keshikan/CureSynth_Whip/hardware/schematic.pdf

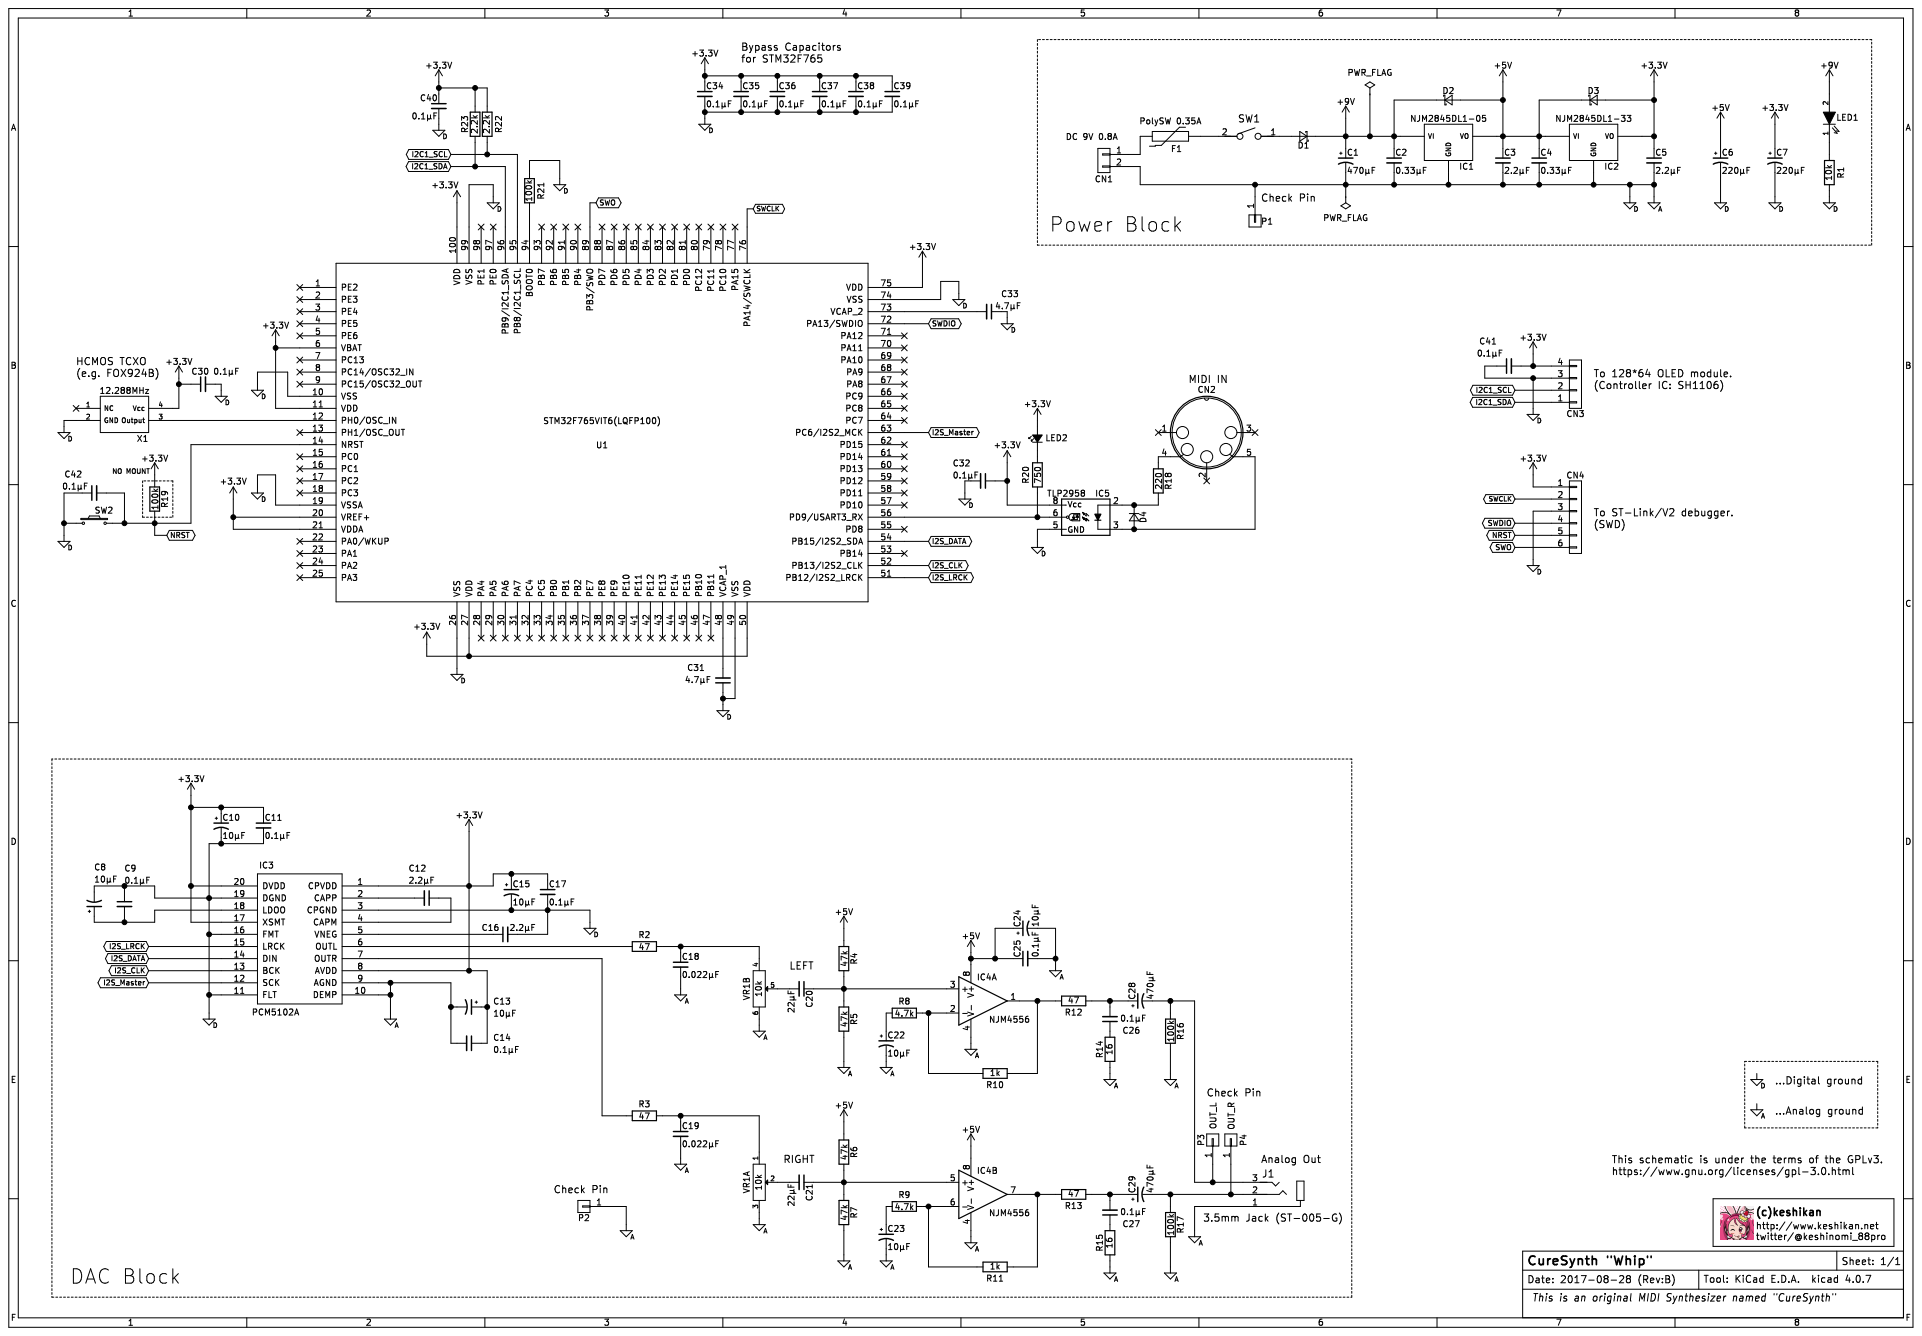
[picture p1: page 1]
