keshikan/CureSynth_Whip/software/SW4STM32_project/Src/main.c

/**
  ******************************************************************************
  * File Name          : main.c
  * Description        : Main program body
  ******************************************************************************
  ** This notice applies to any and all portions of this file
  * that are not between comment pairs USER CODE BEGIN and
  * USER CODE END. Other portions of this file, whether 
  * inserted by the user or by software development tools
  * are owned by their respective copyright owners.
  *
  * COPYRIGHT(c) 2017 STMicroelectronics
  *
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
  ******************************************************************************
  */
/* Includes ------------------------------------------------------------------*/
#include "main.h"
#include "stm32f7xx_hal.h"

/* USER CODE BEGIN Includes */

#include<stdio.h>

#include "curelib_inc/curemidi.h"
#include "curelib_inc/curemisc.h"
#include "curelib_inc/curedisplay.h"
#include "curelib_inc/curedbg.h"


/* USER CODE END Includes */


I2C_HandleTypeDef hi2c1;
DMA_HandleTypeDef hdma_i2c1_tx;

I2S_HandleTypeDef hi2s2;
DMA_HandleTypeDef hdma_spi2_tx;

TIM_HandleTypeDef htim7;

UART_HandleTypeDef huart1;
UART_HandleTypeDef huart3;

/* USER CODE BEGIN PV */

//for MIDI rx
uint8_t midi_recieved_buf;

//for audio output
int16_t audio_output[2];
uint16_t audio_output_i2s[2];
uint8_t i2s_transmitted=true;

//for output buffer
#define OUTPUT_BUFFERSIZE (1024) //need 2^n

typedef struct{

	uint16_t buffer[OUTPUT_BUFFERSIZE * 2];
	volatile uint16_t idx;
	uint8_t started_flag;
	int16_t err_distance;

}OutputBuffer;

OutputBuffer outbuf;

//for display
uint8_t display_update_flag = false;

/* USER CODE END PV */

void SystemClock_Config(void);
static void MX_GPIO_Init(void);
static void MX_DMA_Init(void);
static void MX_USART3_UART_Init(void);
static void MX_TIM7_Init(void);
static void MX_I2S2_Init(void);
static void MX_USART1_UART_Init(void);
static void MX_I2C1_Init(void);
static void MX_NVIC_Init(void);

/* USER CODE BEGIN PFP */

/* USER CODE END PFP */

/* USER CODE BEGIN 0 */

void cureInit(){

	outbuf.idx = 0;
	outbuf.started_flag = false;
	outbuf.err_distance = 0;

	HAL_I2C_Master_Transmit(&hi2c1, 0x78, disp_settings, DISP_INITSIZE, 1000);
	HAL_I2C_Master_Transmit(&hi2c1, 0x78, (uint8_t *)disp_memory, 2096, 1000);

}

void cureErr()
{
	while(1);
}

void cureMonitoringBuffer()
{
	//monitoring output buffer.
	if(outbuf.err_distance < -1 * OUTPUT_BUFFERSIZE){ //if buffer under-run error occurs.
		outbuf.idx += OUTPUT_BUFFERSIZE;
		outbuf.err_distance += OUTPUT_BUFFERSIZE;
	}else if (OUTPUT_BUFFERSIZE < outbuf.err_distance){ //if buffer over-run error occurs.
		outbuf.idx -= OUTPUT_BUFFERSIZE;
		outbuf.err_distance -= OUTPUT_BUFFERSIZE;
	}
}

void cureUpdateDisplay()
{
	if(disp_transmitted == true){
		cureSynthUpdateDisplayData();
		displaySetData(display_data);
		HAL_I2C_Master_Transmit_DMA(&hi2c1, 0x78, (uint8_t *)disp_memory, 2096);
		disp_transmitted = false;
	}
}


void HAL_I2C_MasterTxCpltCallback(I2C_HandleTypeDef *hi2c){

	if(hi2c->Instance == I2C1)
	{
		disp_transmitted = true;
	}
}

void HAL_UART_RxCpltCallback(UART_HandleTypeDef *huart)
{
	if(huart->Instance == USART3)
	{

		GPIOC->ODR |= GPIO_PIN_9;
		cureMidiBufferEnqueue(&midi_recieved_buf);
		HAL_UART_Receive_IT(&huart3, &midi_recieved_buf,1);
	}
}

void HAL_UART_TxCpltCallback(UART_HandleTypeDef *huart){
	if(huart->Instance == USART1)
	{
	}
}

void HAL_UART_ErrorCallback(UART_HandleTypeDef *huart){


}

void HAL_TIM_PeriodElapsedCallback(TIM_HandleTypeDef *htim)
{

	if(htim->Instance == TIM7)
	{
#if CUREDBG_CPU_USAGE
		GPIOA->ODR |= GPIO_PIN_0;
#endif

		cureSynthGetOutput(audio_output);

		audio_output_i2s[0] = (uint16_t)(audio_output[0] + 32768);
		audio_output_i2s[1] = (uint16_t)(audio_output[1] + 32768);

		//store output buffer
		outbuf.buffer[outbuf.idx] = audio_output_i2s[0];
		outbuf.buffer[outbuf.idx+1] = audio_output_i2s[1];
		outbuf.idx+=2;
		outbuf.idx &= (OUTPUT_BUFFERSIZE*2 -1);
		outbuf.err_distance+=2;

		//set internal DAC.
//		HAL_DAC_SetValue(&hdac, DAC_CHANNEL_1, DAC_ALIGN_12B_R, (uint32_t)(audio_output_i2s[0] >> 4) );
//		HAL_DAC_SetValue(&hdac, DAC_CHANNEL_2, DAC_ALIGN_12B_R, (uint32_t)(audio_output_i2s[1] >> 4) );


#if CUREDBG_CPU_USAGE
		GPIOA->ODR &= ~GPIO_PIN_0;
#endif

	}


}

void HAL_I2S_TxHalfCpltCallback(I2S_HandleTypeDef *hi2s){

	if(hi2s->Instance == SPI2)
	{
		outbuf.err_distance -= OUTPUT_BUFFERSIZE;
	}
}

void HAL_I2S_TxCpltCallback(I2S_HandleTypeDef *hi2s){

	if(hi2s->Instance == SPI2)
	{
		outbuf.err_distance -= OUTPUT_BUFFERSIZE;
	}
}

/* USER CODE END 0 */

int main(void)
{

  /* Enable I-Cache-------------------------------------------------------------*/
  SCB_EnableICache();

  /* Enable D-Cache-------------------------------------------------------------*/
  SCB_EnableDCache();

  /* MCU Configuration----------------------------------------------------------*/

  /* Reset of all peripherals, Initializes the Flash interface and the Systick. */
  HAL_Init();

  /* USER CODE BEGIN Init */

	setbuf(stdout, NULL);

  /* USER CODE END Init */

  /* Configure the system clock */
  SystemClock_Config();

  /* Initialize all configured peripherals */
  MX_GPIO_Init();
  MX_DMA_Init();
  MX_USART3_UART_Init();
  MX_TIM7_Init();
  MX_I2S2_Init();
  MX_USART1_UART_Init();
  MX_I2C1_Init();

  /* Initialize interrupts */
  MX_NVIC_Init();

  /* USER CODE BEGIN 2 */

	//MIDI Initializations.
	if( FUNC_ERROR == cureMidiInit() ){
#if CUREDBG_UART
		printf("Initialization failed.");
#endif
		while(1);
	}

	//start internal DAC
//	HAL_DAC_Start(&hdac, DAC_CHANNEL_1);
//	HAL_DAC_Start(&hdac, DAC_CHANNEL_2);

	//start MIDI message reception with interrupt.
	HAL_UART_Receive_IT(&huart3, &midi_recieved_buf, 1);

	//start sound generate timer.
	HAL_TIM_Base_Start_IT(&htim7);


#if CUREDBG_UART
	printf("\r\n-----------------------------------------\r\n");
	printf("CureSynth System (F7 Edition) is running.\r\n");
	printf("-----------------------------------------\r\n");

	printf("char_size=%d\r\n",sizeof(char));
	printf("short_size=%d\r\n",sizeof(short));
	printf("int_size=%d\r\n",sizeof(int));
	printf("long_size=%d\r\n",sizeof(long));
	printf("longlong_size=%d\r\n",sizeof(long long));
	printf("-----------------------------------------\r\n\r\n");

#endif


	//start display data sending.

	displayInit();
	cureInit();

	while(1)
	{
		if((outbuf.idx) > ( OUTPUT_BUFFERSIZE ) ){
			HAL_I2S_Transmit_DMA(&hi2s2, outbuf.buffer, OUTPUT_BUFFERSIZE * 2);
			outbuf.err_distance = 0;
			break;
		}
	}


  /* USER CODE END 2 */

  /* Infinite loop */
  /* USER CODE BEGIN WHILE */
	while (1)
	{
  /* USER CODE END WHILE */

  /* USER CODE BEGIN 3 */

		cureMidiMain();

		//MIDI LED OFF
		GPIOC->ODR &= ~GPIO_PIN_9;

		cureMonitoringBuffer();

		if( cureMidiBufferIsEmpty() ){
			cureUpdateDisplay();
		}

	}
  /* USER CODE END 3 */

}

/** System Clock Configuration
*/
void SystemClock_Config(void)
{

  RCC_OscInitTypeDef RCC_OscInitStruct;
  RCC_ClkInitTypeDef RCC_ClkInitStruct;
  RCC_PeriphCLKInitTypeDef PeriphClkInitStruct;

    /**Configure the main internal regulator output voltage 
    */
  __HAL_RCC_PWR_CLK_ENABLE();

  __HAL_PWR_VOLTAGESCALING_CONFIG(PWR_REGULATOR_VOLTAGE_SCALE1);

    /**Initializes the CPU, AHB and APB busses clocks 
    */
  RCC_OscInitStruct.OscillatorType = RCC_OSCILLATORTYPE_HSI|RCC_OSCILLATORTYPE_HSE;
  RCC_OscInitStruct.HSEState = RCC_HSE_ON;
  RCC_OscInitStruct.HSIState = RCC_HSI_ON;
  RCC_OscInitStruct.HSICalibrationValue = 11;
  RCC_OscInitStruct.PLL.PLLState = RCC_PLL_ON;
  RCC_OscInitStruct.PLL.PLLSource = RCC_PLLSOURCE_HSE;
  RCC_OscInitStruct.PLL.PLLM = 6;
  RCC_OscInitStruct.PLL.PLLN = 210;
  RCC_OscInitStruct.PLL.PLLP = RCC_PLLP_DIV2;
  RCC_OscInitStruct.PLL.PLLQ = 2;
  if (HAL_RCC_OscConfig(&RCC_OscInitStruct) != HAL_OK)
  {
    _Error_Handler(__FILE__, __LINE__);
  }

    /**Activate the Over-Drive mode 
    */
  if (HAL_PWREx_EnableOverDrive() != HAL_OK)
  {
    _Error_Handler(__FILE__, __LINE__);
  }

    /**Initializes the CPU, AHB and APB busses clocks 
    */
  RCC_ClkInitStruct.ClockType = RCC_CLOCKTYPE_HCLK|RCC_CLOCKTYPE_SYSCLK
                              |RCC_CLOCKTYPE_PCLK1|RCC_CLOCKTYPE_PCLK2;
  RCC_ClkInitStruct.SYSCLKSource = RCC_SYSCLKSOURCE_PLLCLK;
  RCC_ClkInitStruct.AHBCLKDivider = RCC_SYSCLK_DIV1;
  RCC_ClkInitStruct.APB1CLKDivider = RCC_HCLK_DIV4;
  RCC_ClkInitStruct.APB2CLKDivider = RCC_HCLK_DIV2;

  if (HAL_RCC_ClockConfig(&RCC_ClkInitStruct, FLASH_LATENCY_7) != HAL_OK)
  {
    _Error_Handler(__FILE__, __LINE__);
  }

  PeriphClkInitStruct.PeriphClockSelection = RCC_PERIPHCLK_USART1|RCC_PERIPHCLK_USART3
                              |RCC_PERIPHCLK_I2C1|RCC_PERIPHCLK_I2S;
  PeriphClkInitStruct.PLLI2S.PLLI2SN = 144;
  PeriphClkInitStruct.PLLI2S.PLLI2SP = RCC_PLLP_DIV2;
  PeriphClkInitStruct.PLLI2S.PLLI2SR = 3;
  PeriphClkInitStruct.PLLI2S.PLLI2SQ = 2;
  PeriphClkInitStruct.PLLI2SDivQ = 1;
  PeriphClkInitStruct.I2sClockSelection = RCC_I2SCLKSOURCE_PLLI2S;
  PeriphClkInitStruct.Usart1ClockSelection = RCC_USART1CLKSOURCE_PCLK2;
  PeriphClkInitStruct.Usart3ClockSelection = RCC_USART3CLKSOURCE_HSI;
  PeriphClkInitStruct.I2c1ClockSelection = RCC_I2C1CLKSOURCE_PCLK1;
  if (HAL_RCCEx_PeriphCLKConfig(&PeriphClkInitStruct) != HAL_OK)
  {
    _Error_Handler(__FILE__, __LINE__);
  }

    /**Configure the Systick interrupt time 
    */
  HAL_SYSTICK_Config(HAL_RCC_GetHCLKFreq()/1000);

    /**Configure the Systick 
    */
  HAL_SYSTICK_CLKSourceConfig(SYSTICK_CLKSOURCE_HCLK);

  /* SysTick_IRQn interrupt configuration */
  HAL_NVIC_SetPriority(SysTick_IRQn, 0, 0);
}

/** NVIC Configuration
*/
static void MX_NVIC_Init(void)
{
  /* DMA1_Stream4_IRQn interrupt configuration */
  HAL_NVIC_SetPriority(DMA1_Stream4_IRQn, 0, 1);
  HAL_NVIC_EnableIRQ(DMA1_Stream4_IRQn);
  /* DMA1_Stream6_IRQn interrupt configuration */
  HAL_NVIC_SetPriority(DMA1_Stream6_IRQn, 2, 0);
  HAL_NVIC_EnableIRQ(DMA1_Stream6_IRQn);
  /* I2C1_EV_IRQn interrupt configuration */
  HAL_NVIC_SetPriority(I2C1_EV_IRQn, 2, 0);
  HAL_NVIC_EnableIRQ(I2C1_EV_IRQn);
}

/* I2C1 init function */
static void MX_I2C1_Init(void)
{

  hi2c1.Instance = I2C1;
  hi2c1.Init.Timing = 0x00201269;
  hi2c1.Init.OwnAddress1 = 0;
  hi2c1.Init.AddressingMode = I2C_ADDRESSINGMODE_7BIT;
  hi2c1.Init.DualAddressMode = I2C_DUALADDRESS_DISABLE;
  hi2c1.Init.OwnAddress2 = 0;
  hi2c1.Init.OwnAddress2Masks = I2C_OA2_NOMASK;
  hi2c1.Init.GeneralCallMode = I2C_GENERALCALL_DISABLE;
  hi2c1.Init.NoStretchMode = I2C_NOSTRETCH_DISABLE;
  if (HAL_I2C_Init(&hi2c1) != HAL_OK)
  {
    _Error_Handler(__FILE__, __LINE__);
  }

    /**Configure Analogue filter 
    */
  if (HAL_I2CEx_ConfigAnalogFilter(&hi2c1, I2C_ANALOGFILTER_ENABLE) != HAL_OK)
  {
    _Error_Handler(__FILE__, __LINE__);
  }

    /**Configure Digital filter 
    */
  if (HAL_I2CEx_ConfigDigitalFilter(&hi2c1, 0) != HAL_OK)
  {
    _Error_Handler(__FILE__, __LINE__);
  }

    /**I2C Enable Fast Mode Plus 
    */
  HAL_I2CEx_EnableFastModePlus(I2C_FASTMODEPLUS_I2C1);

}

/* I2S2 init function */
static void MX_I2S2_Init(void)
{

  hi2s2.Instance = SPI2;
  hi2s2.Init.Mode = I2S_MODE_MASTER_TX;
  hi2s2.Init.Standard = I2S_STANDARD_MSB;
  hi2s2.Init.DataFormat = I2S_DATAFORMAT_16B_EXTENDED;
  hi2s2.Init.MCLKOutput = I2S_MCLKOUTPUT_ENABLE;
  hi2s2.Init.AudioFreq = 32000;
  hi2s2.Init.CPOL = I2S_CPOL_HIGH;
  hi2s2.Init.ClockSource = I2S_CLOCK_PLL;
  if (HAL_I2S_Init(&hi2s2) != HAL_OK)
  {
    _Error_Handler(__FILE__, __LINE__);
  }

}

/* TIM7 init function */
static void MX_TIM7_Init(void)
{

  TIM_MasterConfigTypeDef sMasterConfig;

  htim7.Instance = TIM7;
  htim7.Init.Prescaler = 59;
  htim7.Init.CounterMode = TIM_COUNTERMODE_UP;
  htim7.Init.Period = 55;
  htim7.Init.AutoReloadPreload = TIM_AUTORELOAD_PRELOAD_DISABLE;
  if (HAL_TIM_Base_Init(&htim7) != HAL_OK)
  {
    _Error_Handler(__FILE__, __LINE__);
  }

  sMasterConfig.MasterOutputTrigger = TIM_TRGO_RESET;
  sMasterConfig.MasterSlaveMode = TIM_MASTERSLAVEMODE_DISABLE;
  if (HAL_TIMEx_MasterConfigSynchronization(&htim7, &sMasterConfig) != HAL_OK)
  {
    _Error_Handler(__FILE__, __LINE__);
  }

}

/* USART1 init function */
static void MX_USART1_UART_Init(void)
{

  huart1.Instance = USART1;
  huart1.Init.BaudRate = 1843200;
  huart1.Init.WordLength = UART_WORDLENGTH_8B;
  huart1.Init.StopBits = UART_STOPBITS_1;
  huart1.Init.Parity = UART_PARITY_NONE;
  huart1.Init.Mode = UART_MODE_TX;
  huart1.Init.HwFlowCtl = UART_HWCONTROL_NONE;
  huart1.Init.OverSampling = UART_OVERSAMPLING_16;
  huart1.Init.OneBitSampling = UART_ONE_BIT_SAMPLE_DISABLE;
  huart1.AdvancedInit.AdvFeatureInit = UART_ADVFEATURE_NO_INIT;
  if (HAL_UART_Init(&huart1) != HAL_OK)
  {
    _Error_Handler(__FILE__, __LINE__);
  }

}

/* USART3 init function */
static void MX_USART3_UART_Init(void)
{

  huart3.Instance = USART3;
  huart3.Init.BaudRate = 31250;
  huart3.Init.WordLength = UART_WORDLENGTH_8B;
  huart3.Init.StopBits = UART_STOPBITS_1;
  huart3.Init.Parity = UART_PARITY_NONE;
  huart3.Init.Mode = UART_MODE_RX;
  huart3.Init.HwFlowCtl = UART_HWCONTROL_NONE;
  huart3.Init.OverSampling = UART_OVERSAMPLING_16;
  huart3.Init.OneBitSampling = UART_ONE_BIT_SAMPLE_DISABLE;
  huart3.AdvancedInit.AdvFeatureInit = UART_ADVFEATURE_NO_INIT;
  if (HAL_UART_Init(&huart3) != HAL_OK)
  {
    _Error_Handler(__FILE__, __LINE__);
  }

}

/** 
  * Enable DMA controller clock
  */
static void MX_DMA_Init(void) 
{
  /* DMA controller clock enable */
  __HAL_RCC_DMA1_CLK_ENABLE();

}

/** Configure pins as 
        * Analog 
        * Input 
        * Output
        * EVENT_OUT
        * EXTI
*/
static void MX_GPIO_Init(void)
{

  GPIO_InitTypeDef GPIO_InitStruct;

  /* GPIO Ports Clock Enable */
  __HAL_RCC_GPIOC_CLK_ENABLE();
  __HAL_RCC_GPIOH_CLK_ENABLE();
  __HAL_RCC_GPIOB_CLK_ENABLE();
  __HAL_RCC_GPIOD_CLK_ENABLE();
  __HAL_RCC_GPIOA_CLK_ENABLE();

  /*Configure GPIO pins : PC13 PC14 PC15 */
  GPIO_InitStruct.Pin = GPIO_PIN_13|GPIO_PIN_14|GPIO_PIN_15;
  GPIO_InitStruct.Mode = GPIO_MODE_INPUT;
  GPIO_InitStruct.Pull = GPIO_NOPULL;
  HAL_GPIO_Init(GPIOC, &GPIO_InitStruct);

}

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
