keshikan/CureSynth_Whip/software/SW4STM32_project/CureSynth_Whip.ioc

Mcu.UserName=STM32F765VITx
PA13.Signal=SYS_JTMS-SWDIO
PA14.Signal=SYS_JTCK-SWCLK
PA15.Signal=SYS_JTDI
PB12.Signal=I2S2_WS
PB13.Signal=I2S2_CK
PB15.Signal=I2S2_SD
PB3.Signal=SYS_JTDO-SWO
PB4.Signal=SYS_JTRST
PB6.Signal=USART1_TX
PB7.Signal=USART1_RX
PB8.Signal=I2C1_SCL
PB9.Signal=I2C1_SDA
PC13.Signal=GPIO_Input
PC14/OSC32_IN.Signal=GPIO_Input
PC15/OSC32_OUT.Signal=GPIO_Input
PC6.Signal=I2S2_MCK
PD8.Signal=USART3_TX
PD9.GPIO_Label=MIDI_IN_RX
PD9.Signal=USART3_RX
PH0/OSC_IN.Signal=RCC_OSC_IN
PH1/OSC_OUT.Signal=RCC_OSC_OUT
