keshikan/CureSynth_Whip/software/SW4STM32_project/Inc/curelib_inc/patchlist.h

/*
 *******************************************************************************
 *  [patchlist.h]
 *  This header file contains patch-lists for GM1 mode.
 *
 *  This program is under the terms of the GPLv3.
 *  https://www.gnu.org/licenses/gpl-3.0.html
 *
 *  Copyright(c) 2017 Keshikan (www.keshikan.net)
 *******************************************************************************
 */

#ifndef CURELIB_INC_PATCHLIST_H_
#define CURELIB_INC_PATCHLIST_H_

#include "curelib_inc/curemidi.h"

//GM1 Patch for melody instruments.
const MidiPatch patch_melody[128] = {
		// note type  wave  rm  rg  Sweeptyp  spd A  D   SL  SR  R  Nt  Gain
		{NOTE_MELODY, SINE, 31, 70, SWEEP_NONE, 0, 0, 5, 90, 12, 0, 0, 48},
		{NOTE_MELODY, TRIANGLE, 31, 100, SWEEP_NONE, 0, 0, 5, 90, 12, 0, 0, 64},
		{NOTE_MELODY, TRIANGLE, 31, 110, SWEEP_NONE, 0, 0, 5, 90, 12, 0, 0, 64},
		{NOTE_MELODY, SINE, 31, 100, SWEEP_NONE, 0, 0, 15, 90, 12, 0, 0, 50},
		{NOTE_MELODY, SINE, 95, 80, SWEEP_NONE, 0, 0, 5, 90, 12, 0, 0, 34},
		{NOTE_MELODY, SINE, 127, 100, SWEEP_NONE, 0, 0, 5, 90, 12, 0, 0, 34},
		{NOTE_MELODY, SAW, 63, 35, SWEEP_NONE, 0, 0, 10, 50, 9, 0, 0, 30},
		{NOTE_MELODY, SAW, 63, 127, SWEEP_NONE, 0, 0, 10, 50, 23, 0, 0, 50},
		{NOTE_MELODY, TRIANGLE, 127, 90, SWEEP_NONE, 0, 0, 10, 50, 23, 0, 0, 50},
		{NOTE_MELODY, SINE, 115, 80, SWEEP_NONE, 0, 0, 10, 50, 15, 0, 0, 50},
		{NOTE_DRUM, SINE, 95, 40, SWEEP_NONE, 0, 0, 15, 40, 15, 0, 0, 45},
		{NOTE_MELODY, SINE, 95, 80, SWEEP_NONE, 0, 0, 10, 80, 12, 50, 0, 38},
		{NOTE_MELODY, TRIANGLE, 127, 80, SWEEP_NONE, 0, 0, 10, 50, 45, 15, 0, 64},
		{NOTE_DRUM, TRIANGLE, 63, 80, SWEEP_NONE, 0, 0, 5, 50, 80, 0, 0, 66},
		{NOTE_DRUM, TRIANGLE, 79, 45, SWEEP_NONE, 0, 0, 5, 50, 10, 0, 0, 64},
		{NOTE_MELODY, TRIANGLE, 79, 70, SWEEP_NONE, 0, 0, 5, 50, 30, 10, 0, 60},
		{NOTE_MELODY, SINE, 95, 64, SWEEP_NONE, 0, 1, 2, 100, 0, 0, 0, 38},
		{NOTE_MELODY, SINE, 95, 40, SWEEP_NONE, 0, 1, 20, 40, 0, 0, 0, 64},
		{NOTE_MELODY, SINE, 47, 80, SWEEP_NONE, 0, 1, 20, 40, 0, 0, 0, 64},
		{NOTE_MELODY, SQUARE, 95, 127, SWEEP_NONE, 0, 3, 20, 80, 0, 6, 0, 28},
		{NOTE_MELODY, SAW, 95, 127, SWEEP_NONE, 0, 5, 20, 80, 0, 6, 0, 40},
		{NOTE_MELODY, SAW, 63, 127, SWEEP_NONE, 0, 5, 20, 80, 0, 6, 0, 50},
		{NOTE_MELODY, SAW, 63, 40, SWEEP_NONE, 0, 8, 20, 80, 0, 3, 0, 37},
		{NOTE_MELODY, SAW, 63, 40, SWEEP_NONE, 0, 8, 20, 80, 0, 3, 0, 37},
		{NOTE_MELODY, TRIANGLE, 63, 100, SWEEP_NONE, 0, 0, 3, 80, 10, 3, 0, 53},
		{NOTE_MELODY, TRIANGLE, 63, 65, SWEEP_NONE, 0, 0, 3, 80, 10, 3, 0, 50},
		{NOTE_MELODY, TRIANGLE, 95, 100, SWEEP_NONE, 0, 0, 3, 80, 10, 3, 0, 48},
		{NOTE_MELODY, TRIANGLE, 95, 65, SWEEP_NONE, 0, 0, 3, 80, 10, 3, 0, 46},
		{NOTE_MELODY, TRIANGLE, 95, 65, SWEEP_NONE, 0, 0, 3, 80, 52, 3, 0, 64},
		{NOTE_MELODY, SQUARE, 95, 100, SWEEP_NONE, 0, 0, 3, 80, 0, 3, 0, 30},
		{NOTE_MELODY, SQUARE, 79, 80, SWEEP_NONE, 0, 0, 3, 80, 0, 3, 0, 31},
		{NOTE_MELODY, SQUARE, 31, 120, SWEEP_NONE, 0, 0, 3, 80, 5, 3, 0, 50},
		{NOTE_MELODY, TRIANGLE, 63, 120, SWEEP_NONE, 0, 0, 2, 80, 4, 3, 0, 57},
		{NOTE_MELODY, TRIANGLE, 63, 40, SWEEP_NONE, 0, 0, 2, 80, 4, 3, 0, 47},
		{NOTE_MELODY, SINE, 63, 40, SWEEP_NONE, 0, 0, 2, 80, 4, 3, 0, 45},
		{NOTE_MELODY, SAW, 31, 120, SWEEP_NONE, 0, 0, 2, 80, 4, 3, 0, 70},
		{NOTE_MELODY, SAW, 63, 90, SWEEP_NONE, 0, 0, 5, 60, 4, 3, 0, 55},
		{NOTE_MELODY, SAW, 63, 110, SWEEP_NONE, 0, 0, 5, 60, 4, 3, 0, 55},
		{NOTE_MELODY, SQUARE, 63, 20, SWEEP_NONE, 0, 0, 5, 60, 4, 3, 0, 40},
		{NOTE_MELODY, SQUARE, 63, 70, SWEEP_NONE, 0, 0, 5, 60, 4, 3, 0, 40},
		{NOTE_MELODY, SAW, 63, 70, SWEEP_NONE, 0, 8, 5, 60, 0, 6, 0, 62},
		{NOTE_MELODY, SAW, 63, 110, SWEEP_NONE, 0, 8, 5, 60, 0, 6, 0, 65},
		{NOTE_MELODY, SAW, 63, 120, SWEEP_NONE, 0, 8, 5, 60, 0, 6, 0, 64},
		{NOTE_MELODY, SAW, 95, 127, SWEEP_NONE, 0, 8, 5, 60, 0, 6, 0, 58},
		{NOTE_MELODY, SQUARE, 31, 127, SWEEP_NONE, 0, 8, 5, 60, 0, 6, 0, 64},
		{NOTE_DRUM, SQUARE, 31, 127, SWEEP_NONE, 0, 0, 5, 60, 75, 0, 0, 64},
		{NOTE_MELODY, TRIANGLE, 31, 80, SWEEP_NONE, 0, 0, 4, 60, 30, 15, 0, 73},
		{NOTE_MELODY, TRIANGLE, 31, 40, SWEEP_NONE, 0, 0, 4, 30, 10, 30, 0, 120},
		{NOTE_MELODY, SQUARE, 31, 105, SWEEP_NONE, 0, 8, 5, 60, 0, 6, 0, 60},
		{NOTE_MELODY, SQUARE, 31, 105, SWEEP_NONE, 0, 25, 20, 80, 0, 6, 0, 52},
		{NOTE_MELODY, SAW, 31, 110, SWEEP_NONE, 0, 15, 20, 80, 0, 6, 0, 64},
		{NOTE_MELODY, SAW, 31, 127, SWEEP_NONE, 0, 15, 20, 80, 0, 6, 0, 64},
		{NOTE_MELODY, SAW, 47, 127, SWEEP_NONE, 0, 15, 20, 80, 0, 6, 0, 46},
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
		{NOTE_MELODY, SAW, 95, 100, SWEEP_NONE, 0, 8, 3, 45, 0, 3, 0, 55},
		{NOTE_MELODY, SINE, 79, 100, SWEEP_NONE, 0, 0, 8, 45, 25, 35, 0, 55},
		{NOTE_DRUM, SINE, 127, 100, SWEEP_NONE, 40, 0, 8, 45, 110, 6, 0, 48},
		{NOTE_DRUM, SINE, 127, 110, SWEEP_NONE, 0, 0, 8, 45, 52, 5, 0, 48},
		{NOTE_DRUM, SINE, 100, 50, SWEEP_NONE, 50, 0, 8, 45, 120, 5, 0, 48},
		{NOTE_DRUM, TRIANGLE, 20, 127, SWEEP_DOWN, 35, 0, 8, 80, 127, 5, 0, 48},
		{NOTE_DRUM, SINE, 31, 127, SWEEP_DOWN, 35, 0, 8, 80, 127, 5, 0, 48},
		{NOTE_DRUM, SQUARE, 31, 127, SWEEP_DOWN, 35, 0, 8, 80, 127, 5, 0, 48},
		{NOTE_DRUM, NOISE, 31, 0, SWEEP_NONE, 5, 127, 8, 127, 0, 5, 0, 23},
		{NOTE_DRUM, SQUARE, 31, 127, SWEEP_UP, 30, 3, 8, 50, 0, 5, 0, 40},
		{NOTE_DRUM, NOISE, 31, 0, SWEEP_NONE, 10, 8, 8, 50, 127, 5, 0, 20},
		{NOTE_MELODY, NOISE, 0, 127, SWEEP_NONE, 0, 8, 8, 50, 0, 5, 0, 35},
		{NOTE_MELODY, SINE, 0, 0, SWEEP_UP, 100, 8, 8, 50, 0, 5, 0, 25},
		{NOTE_MELODY, SINE, 0, 127, SWEEP_NONE, 0, 0, 0, 127, 0, 0, 0, 25},
		{NOTE_MELODY, NOISE, 1, 127, SWEEP_NONE, 0, 127, 0, 127, 0, 50, 0, 17},
		{NOTE_MELODY, NOISE, 3, 127, SWEEP_NONE, 0, 127, 0, 127, 0, 30, 0, 17},
		{NOTE_MELODY, NOISE, 10, 127, SWEEP_NONE, 0, 0, 10, 100, 40, 3, 0, 17}

};

//GM1 Patch for drums.
const MidiPatch patch_drum[128] = {
		// note type  wave  rm  rg  Sweeptyp  spd A  D   SL  SR  R  Nt  Gain
		{NOTE_DRUM, SQUARE, 31, 127, SWEEP_DOWN, 64, 0, 0, 127, 0, 0, 38, 60},
		{NOTE_DRUM, SQUARE, 31, 127, SWEEP_DOWN, 64, 0, 0, 127, 0, 0, 38, 60},
		{NOTE_DRUM, SQUARE, 31, 127, SWEEP_DOWN, 64, 0, 0, 127, 0, 0, 38, 60},
		{NOTE_DRUM, SQUARE, 31, 127, SWEEP_DOWN, 64, 0, 0, 127, 0, 0, 38, 60},
		{NOTE_DRUM, SQUARE, 31, 127, SWEEP_DOWN, 64, 0, 0, 127, 0, 0, 38, 60},
		{NOTE_DRUM, SQUARE, 31, 127, SWEEP_DOWN, 64, 0, 0, 127, 0, 0, 38, 60},
		{NOTE_DRUM, SQUARE, 31, 127, SWEEP_DOWN, 64, 0, 0, 127, 0, 0, 38, 60},
		{NOTE_DRUM, SQUARE, 31, 127, SWEEP_DOWN, 64, 0, 0, 127, 0, 0, 38, 60},
		{NOTE_DRUM, SQUARE, 31, 127, SWEEP_DOWN, 64, 0, 0, 127, 0, 0, 38, 60},
		{NOTE_DRUM, SQUARE, 31, 127, SWEEP_DOWN, 64, 0, 0, 127, 0, 0, 38, 60},
		{NOTE_DRUM, SQUARE, 31, 127, SWEEP_DOWN, 64, 0, 0, 127, 0, 0, 38, 60},
		{NOTE_DRUM, SQUARE, 31, 127, SWEEP_DOWN, 64, 0, 0, 127, 0, 0, 38, 60},
		{NOTE_DRUM, SQUARE, 31, 127, SWEEP_DOWN, 64, 0, 0, 127, 0, 0, 38, 60},
		{NOTE_DRUM, SQUARE, 31, 127, SWEEP_DOWN, 64, 0, 0, 127, 0, 0, 38, 60},
		{NOTE_DRUM, SQUARE, 31, 127, SWEEP_DOWN, 64, 0, 0, 127, 0, 0, 38, 60},
		{NOTE_DRUM, SQUARE, 31, 127, SWEEP_DOWN, 64, 0, 0, 127, 0, 0, 38, 60},
		{NOTE_DRUM, SQUARE, 31, 127, SWEEP_DOWN, 64, 0, 0, 127, 0, 0, 38, 60},
		{NOTE_DRUM, SQUARE, 31, 127, SWEEP_DOWN, 64, 0, 0, 127, 0, 0, 38, 60},
		{NOTE_DRUM, SQUARE, 31, 127, SWEEP_DOWN, 64, 0, 0, 127, 0, 0, 38, 60},
		{NOTE_DRUM, SQUARE, 31, 127, SWEEP_DOWN, 64, 0, 0, 127, 0, 0, 38, 60},
		{NOTE_DRUM, SQUARE, 31, 127, SWEEP_DOWN, 64, 0, 0, 127, 0, 0, 38, 60},
		{NOTE_DRUM, SQUARE, 31, 127, SWEEP_DOWN, 64, 0, 0, 127, 0, 0, 38, 60},
		{NOTE_DRUM, SQUARE, 31, 127, SWEEP_DOWN, 64, 0, 0, 127, 0, 0, 38, 60},
		{NOTE_DRUM, SQUARE, 31, 127, SWEEP_DOWN, 64, 0, 0, 127, 0, 0, 38, 60},
		{NOTE_DRUM, SQUARE, 31, 127, SWEEP_DOWN, 64, 0, 0, 127, 0, 0, 38, 60},
		{NOTE_DRUM, SQUARE, 31, 127, SWEEP_DOWN, 64, 0, 0, 127, 0, 0, 38, 60},
		{NOTE_DRUM, SQUARE, 31, 127, SWEEP_DOWN, 64, 0, 0, 127, 0, 0, 38, 60},
		{NOTE_DRUM, SQUARE, 31, 127, SWEEP_DOWN, 64, 0, 0, 127, 0, 0, 38, 60},
		{NOTE_DRUM, SQUARE, 31, 127, SWEEP_DOWN, 64, 0, 0, 127, 0, 0, 38, 60},
		{NOTE_DRUM, SQUARE, 31, 127, SWEEP_DOWN, 64, 0, 0, 127, 0, 0, 38, 60},
		{NOTE_DRUM, SQUARE, 31, 127, SWEEP_DOWN, 64, 0, 0, 127, 0, 0, 38, 60},
		{NOTE_DRUM, SQUARE, 31, 127, SWEEP_DOWN, 64, 0, 0, 127, 0, 0, 38, 60},
		{NOTE_DRUM, SQUARE, 31, 127, SWEEP_DOWN, 64, 0, 0, 127, 0, 0, 38, 60},
		{NOTE_DRUM, SQUARE, 31, 127, SWEEP_DOWN, 64, 0, 0, 127, 0, 0, 38, 60},
		{NOTE_DRUM, SQUARE, 31, 127, SWEEP_DOWN, 45, 0, 0, 127, 0, 0, 38, 68},
		{NOTE_DRUM, SQUARE, 31, 127, SWEEP_DOWN, 64, 0, 0, 127, 0, 0, 38, 68},
		{NOTE_DRUM, SQUARE, 63, 127, SWEEP_DOWN, 64, 0, 0, 127, 0, 0, 38, 48},
		{NOTE_DRUM, NOISE, 30, 127, SWEEP_NONE, 0, 0, 0, 20, 127, 0, 38, 60},
		{NOTE_DRUM, NOISE, 0, 0, SWEEP_DOWN, 30, 0, 0, 80, 127, 0, 38, 45},
		{NOTE_DRUM, NOISE, 0, 0, SWEEP_DOWN, 30, 0, 0, 40, 127, 0, 38, 45},
		{NOTE_DRUM, NOISE, 127, 100, SWEEP_DOWN, 30, 0, 0, 55, 127, 0, 60, 60},
		{NOTE_DRUM, TRIANGLE, 31, 63, SWEEP_DOWN, 20, 1, 5, 127, 0, 0, 40, 60},
		{NOTE_DRUM, NOISE, 63, 50, SWEEP_DOWN, 10, 1, 5, 28, 127, 0, 96, 45},
		{NOTE_DRUM, TRIANGLE, 31, 63, SWEEP_DOWN, 20, 1, 5, 127, 0, 0, 46, 60},
		{NOTE_DRUM, NOISE, 63, 50, SWEEP_DOWN, 10, 1, 5, 25, 127, 0, 96, 45},
		{NOTE_DRUM, TRIANGLE, 31, 63, SWEEP_DOWN, 20, 1, 5, 127, 0, 0, 51, 60},
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
		{NOTE_DRUM, SQUARE, 31, 127, SWEEP_DOWN, 64, 0, 0, 127, 0, 0, 38, 60},
		{NOTE_DRUM, SQUARE, 31, 127, SWEEP_DOWN, 64, 0, 0, 127, 0, 0, 38, 60},
		{NOTE_DRUM, SQUARE, 31, 127, SWEEP_DOWN, 64, 0, 0, 127, 0, 0, 38, 60}
};


#endif /* CURELIB_INC_PATCHLIST_H_ */
