keshikan/CureSynth_Whip/(notices)

Notices in the files:
software/SW4STM32_project/Src/main.c:
(C) COPYRIGHT STMicroelectronics *****END OF FILE
